gh0stless/SD2IEC-Tic-Tac-Edition/README.md

# SD2IEC-Tic-Tac-Edition

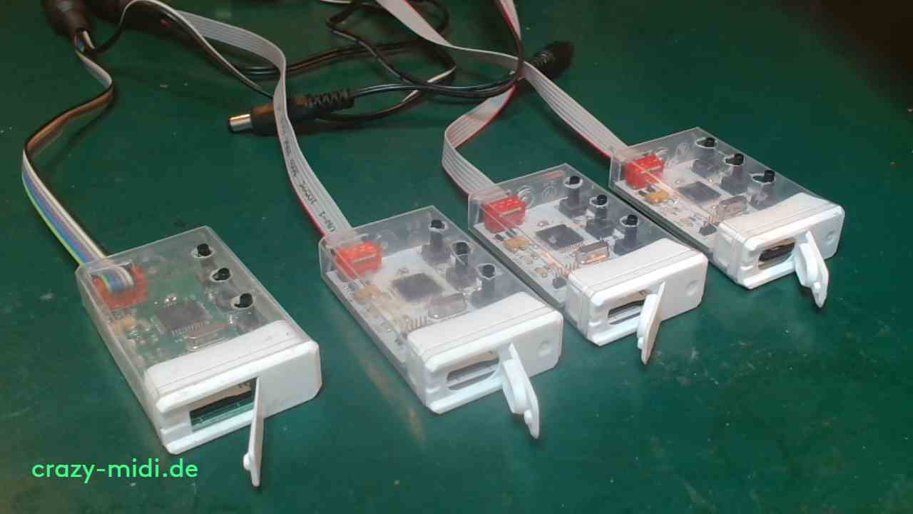
[picture p1: pics/SD2IEC_Tic_Tac.png]
SD2IEC_Tic_Tac


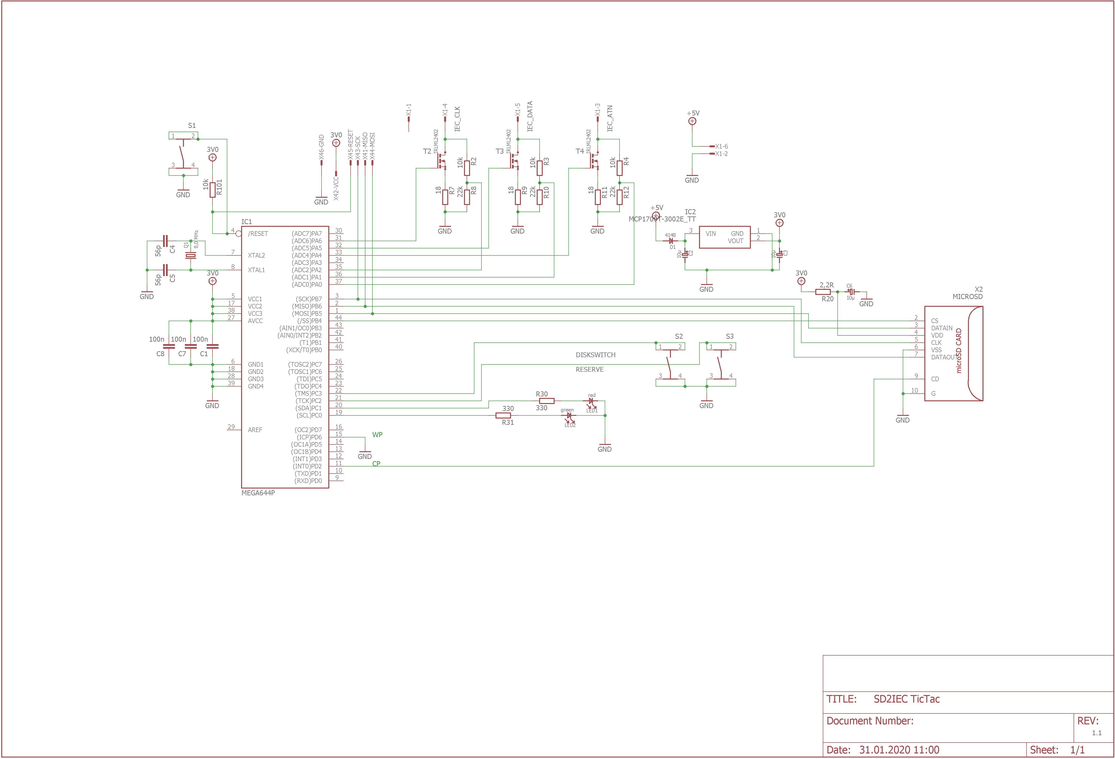
[picture p2: pics/schematic.png]
schematic


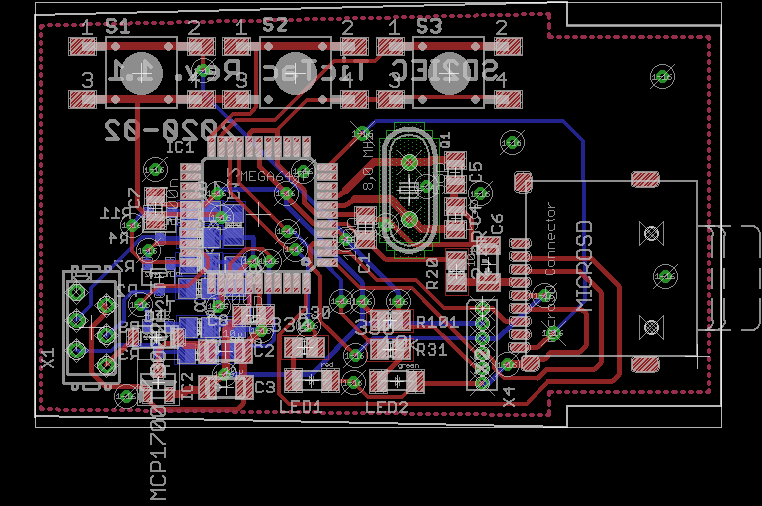
[picture p3: pics/board.png]
board


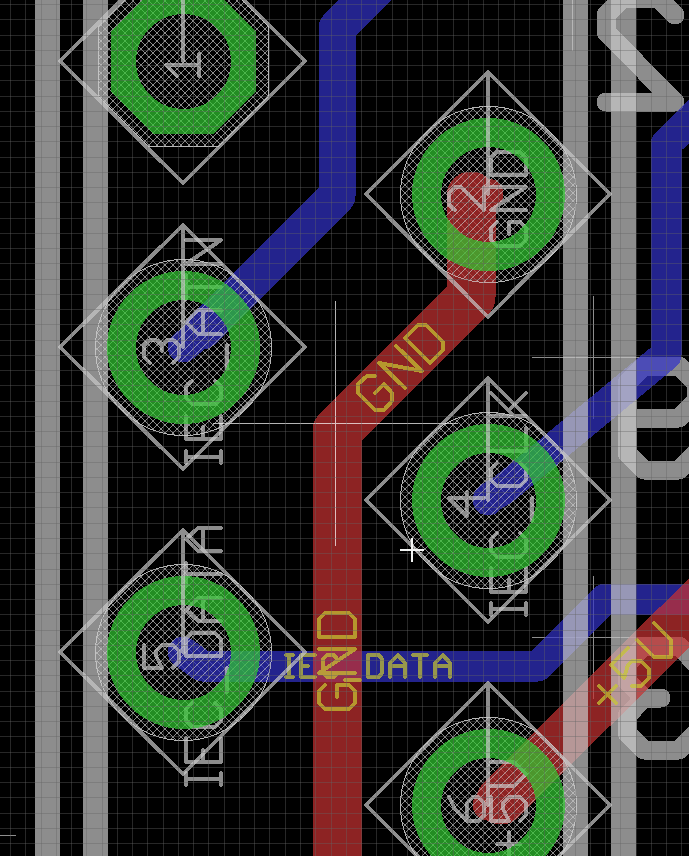
[picture p4: pics/connector.png]
connector


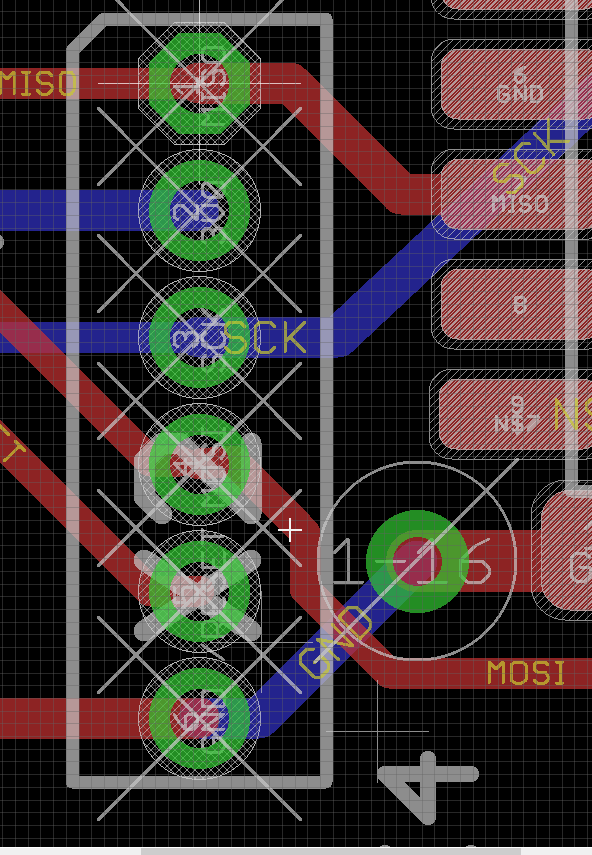
[picture p5: pics/ISP-connector.png]
ISP-connector
