gh0stless/SD2IEC-Tic-Tac-Edition/datasheets/microSD card connector/1.jpg

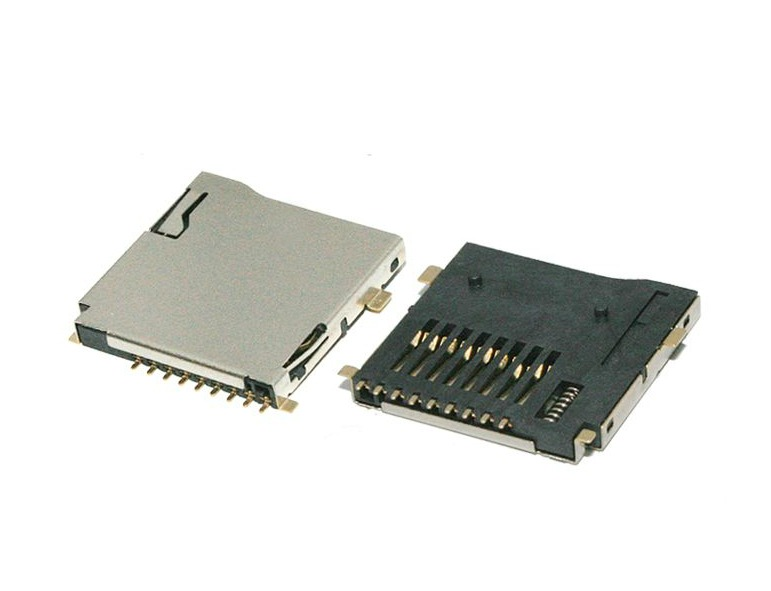
datasheets/microSD card connector/1.jpg
