gh0stless/SD2IEC-Tic-Tac-Edition/datasheets/microSD card connector/2.jpg

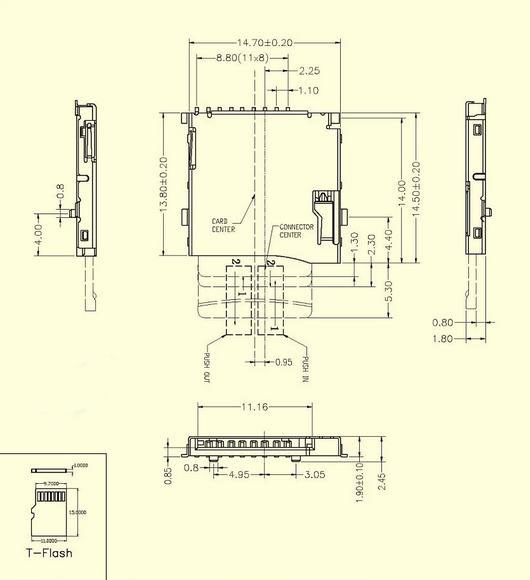
datasheets/microSD card connector/2.jpg
