gh0stless/SD2IEC-Tic-Tac-Edition/datasheets/microSD card connector/3.jpg

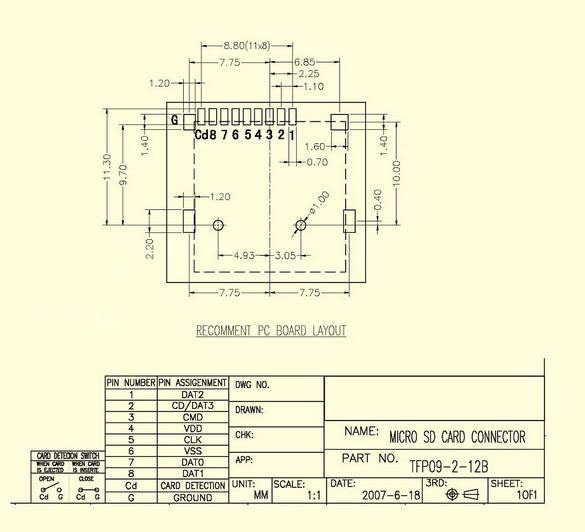
datasheets/microSD card connector/3.jpg
