gh0stless/SD2IEC-Tic-Tac-Edition/datasheets/microSD card connector/HTB1o9D0JFXXXXbVXXXXq6xXFXXX2.jpg

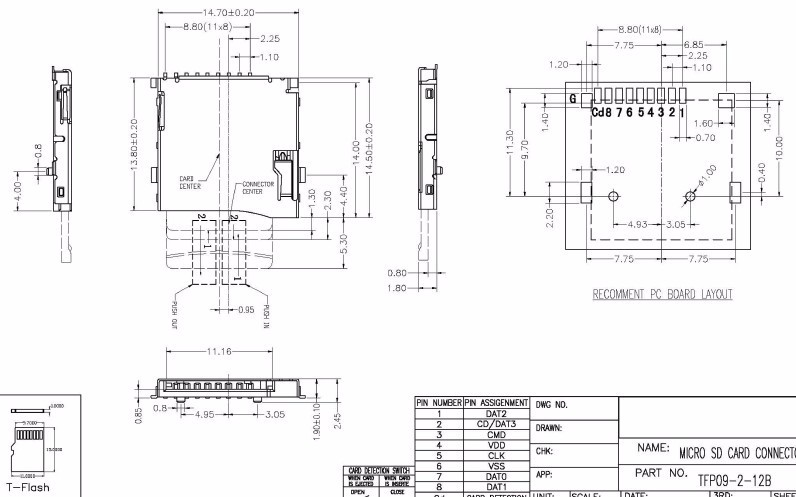
datasheets/microSD card connector/HTB1o9D0JFXXXXbVXXXXq6xXFXXX2.jpg
