gh0stless/SD2IEC-Tic-Tac-Edition/docs/SD2IEC Tic Tac - Bauteilliste (BOM).ods

Bauteilliste uSD2IEC Tic Tac Edition
Bauteil | Bezeichnung | Anzahl | Bauform | Bemerkung | Reichelt
 | PCB | 1
C1, C7, C8 | 100nF | 3 | 0805 |  | KEM X7R0805 100N (https://www.reichelt.de/vielschicht-kerko-100nf-50v-125-c-kem-x7r0805-100n-p207073.html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)
C4, C5 | 56pF | 2 | 0805 |  | KEM C0G0805 56P (https://www.reichelt.de/vielschicht-kerko-56pf-50v-125-c-kem-c0g0805-56p-p207032.html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)
C2, C3, C6 | 10µF | 3 | 0805 |  | T491A 10U 16 (https://www.reichelt.de/smd-tantal-10-f-16v-125-c-t491a-10u-16-p206441.html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)
D1 | 4148 | 1 | SOD-123 |  | 1N 4148W DIO (https://www.reichelt.de/kleinsignal-schalt-diode-100-v-150-ma-sod-123-1n-4148w-dio-p219382.html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)
IC1 | MEGA644P | 1 | TQFP44 |  | ATMEGA 644P20AU (https://www.reichelt.de/8-bit-atmega-avr-mikrocontroller-64-kb-20-mhz-tqfp-44-atmega-644p20au-p188777.html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)
IC2 | MCP1700T-3002E_TT | 1 | SOT95P237X112-3N | HC 6206 | MCP 1700T-3002E (https://www.reichelt.de/ldo-regler-fest-3-v-sot-23-3-mcp-1700t-3002e-p216941.html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)
LED1 | LED1206 red | 1 | 1206 |  | SMD-LED 1206 RT (https://www.reichelt.de/led-smd-3216-1206-rot-12-mcd-120--smd-led-1206-rt-p31439.html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)
LED2 | LED1206 green | 1 | 1206 |  | SMD-LED 1206 GN (https://www.reichelt.de/smd-led-1206-superhell-gruen-gap-12-mcd-120-3-2-x-1-6-mm--smd-led-1206-gn-p31440.html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)
Q1 | 8MHz | 1 | HC49/S |  | 8,0000-HC49U-S (https://www.reichelt.de/standardquarz-grundton-8-000000-mhz-8-0000-hc49u-s-p32845.html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)
R2, R3, R4, R101 | 10k | 4 | 0805 |  | WAL WR08X1002FTL (https://www.reichelt.de/smd-widerstand-0805-10-kohm-125-mw-1--wal-wr08x1002ftl-p346579.html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)
R7, R9, R11 | 18 | 3 | 0805 |  | WAL WR08X18R0FTL (https://www.reichelt.de/smd-widerstand-0805-18-ohm-125-mw-1--wal-wr08x18r0ftl-p346592.html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)
R8, R10, R12 | 22k | 3 | 0805 |  | WAL WR08X2202FTL (https://www.reichelt.de/smd-widerstand-0805-22-kohm-125-mw-1--wal-wr08x2202ftl-p346600.html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)
R20 | 2,2 | 1 | 0805 |  | RND 1550805 AA (https://www.reichelt.de/smd-widerstand-0805-2-2-ohm-125-mw-5--rnd-1550805-aa-p250218.html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)
R30, R31 | 330 | 2 | 0805 |  | RND 1550805 BT (https://www.reichelt.de/smd-widerstand-0805-330-ohm-125-mw-5--rnd-1550805-bt-p250263.html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)
T2,T3,T4 | IRLML2402 | 3 | SOT23 |  | IRLML 2402 (https://www.reichelt.de/mosfet-n-kanal-20-v-1-2-a-rds-on-0-25-ohm-sot-23-irlml-2402-p108736.html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)
S1, S2, S3 | TASTER-9314_SMD | 3
X1 | MICROMATCH-6 | 1 |  | Micromatch Buchse | MPE 369-1-006 (https://www.reichelt.de/buchsenleisten-micromatch-1-27-mm-2x03-gerade-mpe-369-1-006-p120008.html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)
X1-2 | MICROMATCH-6 | 1 |  | Micromatch Stecker | MPE 372-1-006 (https://www.reichelt.de/idc-stiftwanne-micro-match-06-polig-mpe-372-1-006-p120050.html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)
X2 | MICROSD | 1 |  | µSD card slot
X4 | 1X6 | 1 |  | Stiftleisten 1,27 mm 1X50 | SL 1X10G 1,27 (https://www.reichelt.de/10pol-stiftleiste-gerade-rm-1-27-sl-1x10g-1-27-p51692.html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)
 |  | 1 |  | DC-Kabel
 |  | 1 |  | Flachbandkabel-6x
 |  | 1 |  | Hohlstecker,5,5-2,1 | HS 21-9 (https://www.reichelt.de/hohlstecker-knickschutz-aussen-5-5-mm-innen-2-1-mm-hs-21-9-p8647.html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)
 |  | 1 |  | DIN-Stecker, 6-Pol., Hufeisenform | MAS 60 (https://www.reichelt.de/din-stecker-6-polig-mas-60-p11200.html?GROUP=C1651&START=0&SORT=-rank&OFFSET=16&nbc=1)
 |  | 1 |  | DC-DC-Adapter,5,5-2,1 | DC-AD 072241 (https://www.reichelt.de/kupplung-kupplung-aussen-5-5-mm-innen-2-1-mm-dc-ad-072241-p202907.html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)
 |  | 1 |  | µSD Karte 2GB | TS2GUSD (https://www.reichelt.de/microsd-speicherkarte-2gb-transcend-mit-adapter-ts2gusd-p171415.html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)
 |  | 1 |  | Tic Tac Box
