gh0stless/SD2IEC-Tic-Tac-Edition/pcb/SD2IEC TicTac.brd

## EAGLE design pcb/SD2IEC TicTac.brd (2023-07-09)

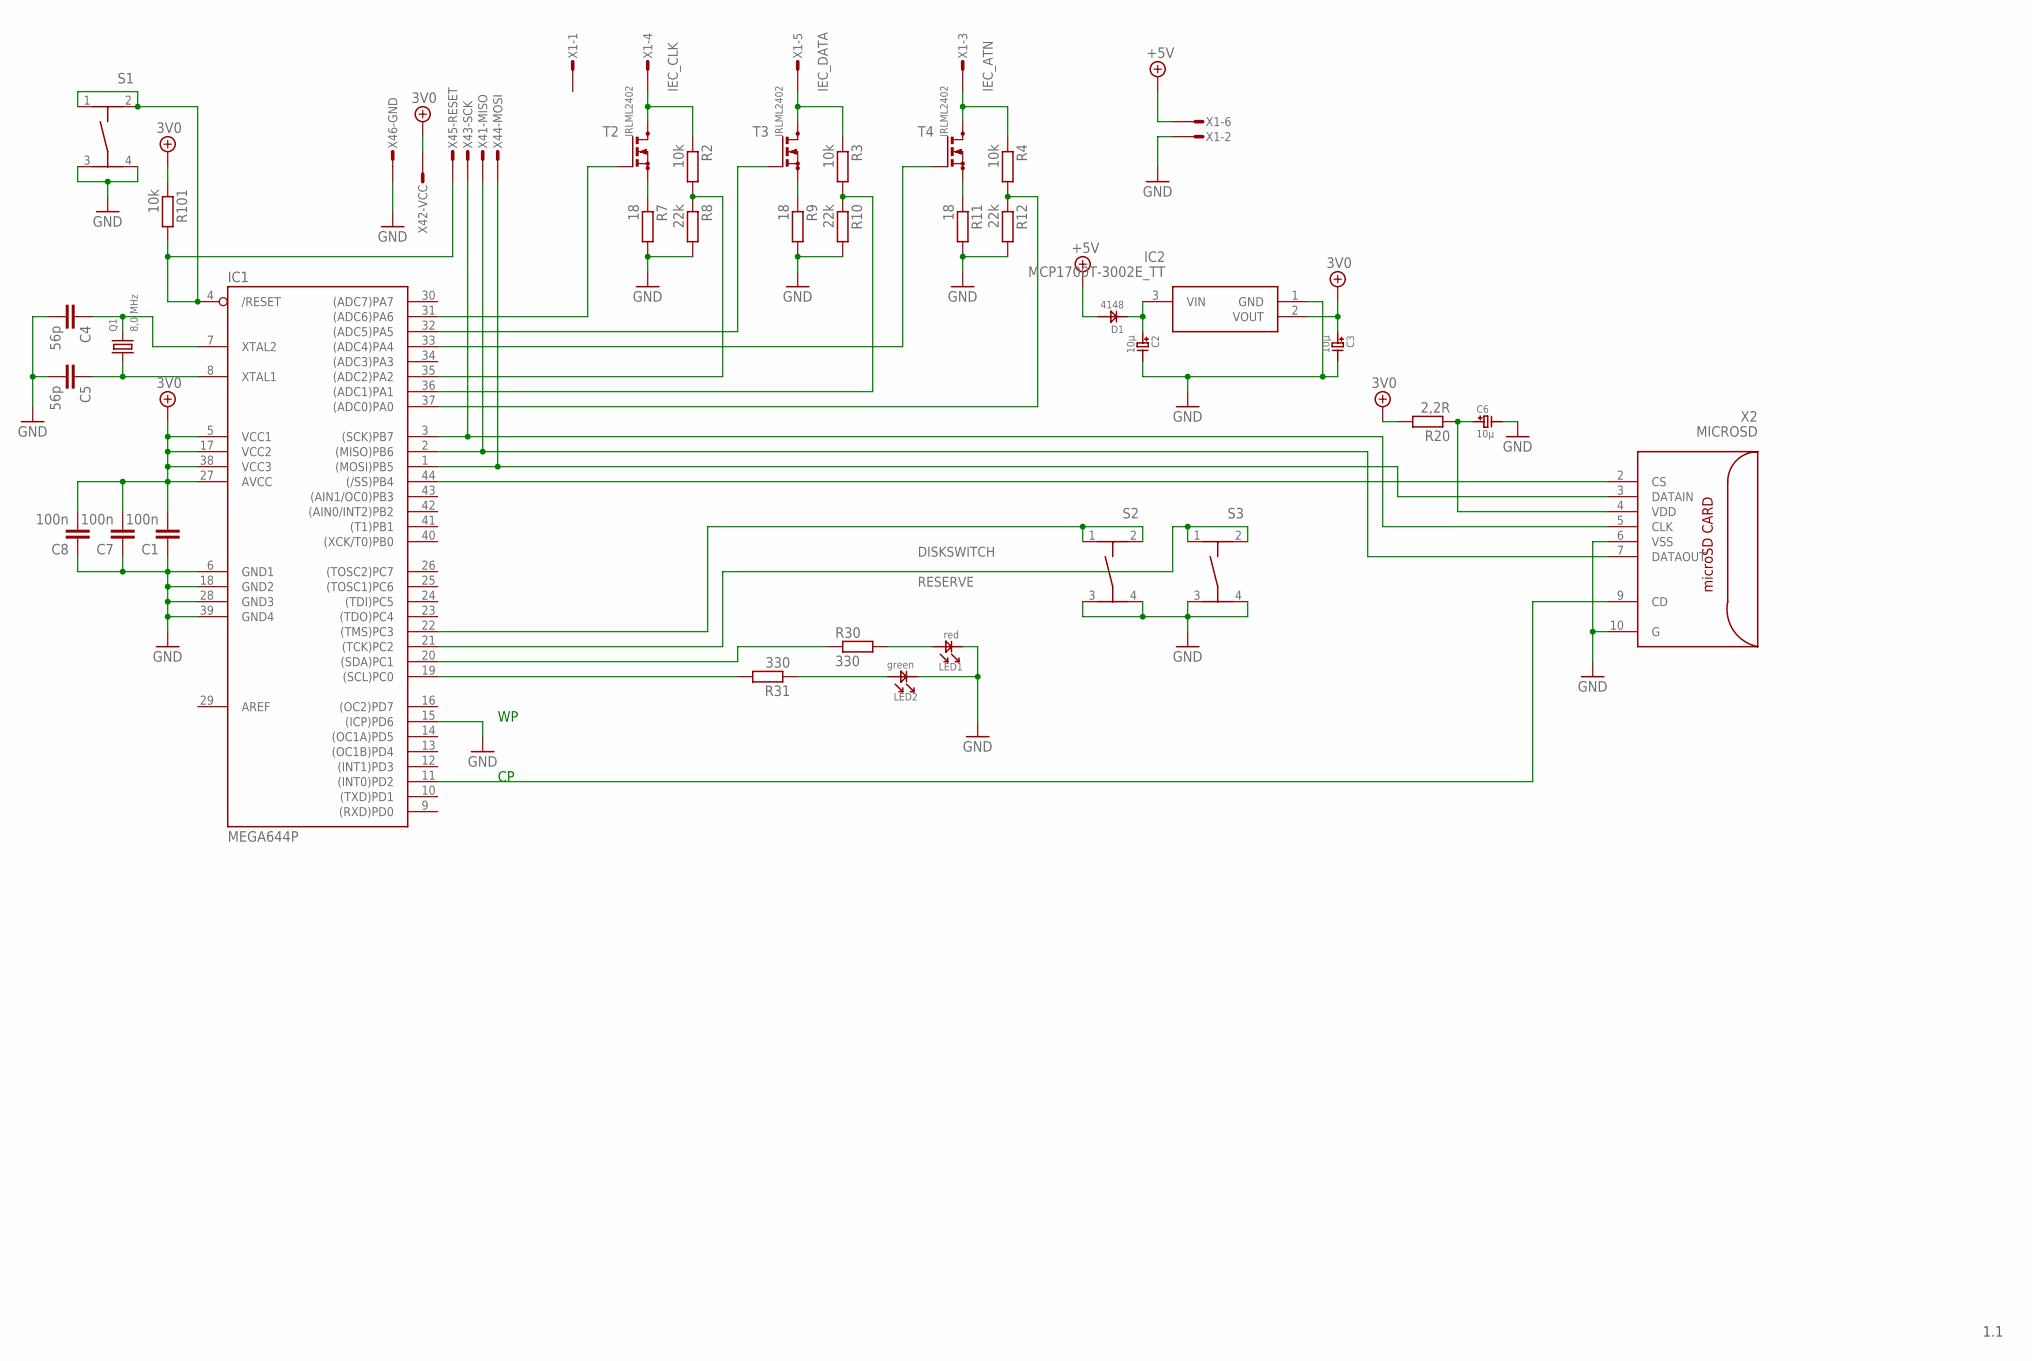
[picture p10: schematic SD2IEC TicTac.sch]

Parts:
C1, C7, C8: 100n; C0805K
C2, C3, C6: 10µ; C_TANTAL_A
C4, C5: 56p; C0805K
D1: 4148; SOD-123
IC1: MEGA644P; TQFP44
IC2: MCP1700T-3002E_TT; SOT95P237X112-3N
LED1: red; LED1206
LED2: green; LED1206
Q1: 8,0 MHz; HC49/S
R2, R3, R4, R101: 10k; R0805
R7, R9, R11: 18; R0805
R8, R10, R12: 22k; R0805
R20: 2,2R; R0805
R30, R31: 330; R0805
S1, S2, S3: TASTER-9314_SMD
T2, T3, T4: IRLML2402; SOT23_C
X1: MICROMATCH-6_PIN; MICROMATCH-6
X2: MICROSD; MICRO_SD_CONNECTOR
X4: AVR-ISP_1X6; 1X6_ISP

Connections:
3V0: C1.2, C3.1, C7.2, C8.2, IC1.5 (VCC1), IC1.17 (VCC2), IC1.27 (AVCC), IC1.38 (VCC3), IC2.2 (VOUT), R20.2, R101.1, X4.2
+5V: D1.2, X1.6
/RESET: IC1.4 (/RESET), R101.2, S1.1, S1.2, X4.5
ATN: IC1.37 ((ADC0)PA0), R4.2, R12.1
CLK: IC1.35 ((ADC2)PA2), R2.2, R8.1
DATA: IC1.36 ((ADC1)PA1), R3.2, R10.1
DISKSWITCH: IC1.22 ((TMS)PC3), S2.1, S2.2
GND: C1.1, C2.2, C3.2, C4.2, C5.2, C6.2, C7.1, C8.1, IC1.6 (GND1), IC1.15 ((ICP)PD6), IC1.18 (GND2), IC1.28 (GND3), IC1.39 (GND4), IC2.1 (GND), LED1.1, LED2.1, R7.2, R8.2, R9.2, R10.2, R11.2, R12.2, S1.3, S1.4, S2.3, S2.4, S3.3, S3.4, X1.2, X2.6 (VSS), X2.10 (G), X4.6
IEC_ATN: R4.1, T4.3 (D), X1.3
IEC_CLK: R2.1, T2.3 (D), X1.4
IEC_DATA: R3.1, T3.3 (D), X1.5
LED2: LED2.2, R31.1
MISO: IC1.2 ((MISO)PB6), X2.7 (DATAOUT), X4.1
MOSI: IC1.1 ((MOSI)PB5), X2.3 (DATAIN), X4.4
unnamed: LED1.2, R30.2
unnamed: C2.1, D1.1, IC2.3 (VIN)
unnamed: C5.1, IC1.8 (XTAL1), Q1.1
unnamed: C4.1, IC1.7 (XTAL2), Q1.2
unnamed: C6.1, R20.1, X2.4 (VDD)
unnamed: IC1.11 ((INT0)PD2), X2.9 (CD)
unnamed: IC1.32 ((ADC5)PA5), T3.1 (G)
unnamed: IC1.33 ((ADC4)PA4), T4.1 (G)
unnamed: IC1.31 ((ADC6)PA6), T2.1 (G)
unnamed: R7.1, T2.2 (S)
unnamed: R9.1, T3.2 (S)
unnamed: R11.1, T4.2 (S)
PC0: IC1.19 ((SCL)PC0), R31.2
PC1: IC1.20 ((SDA)PC1), R30.1
RESERVE: IC1.21 ((TCK)PC2), S3.1, S3.2
SCK: IC1.3 ((SCK)PB7), X2.5 (CLK), X4.3
SS: IC1.44 ((/SS)PB4), X2.2 (CS)

Notes on the sheet:
1.1

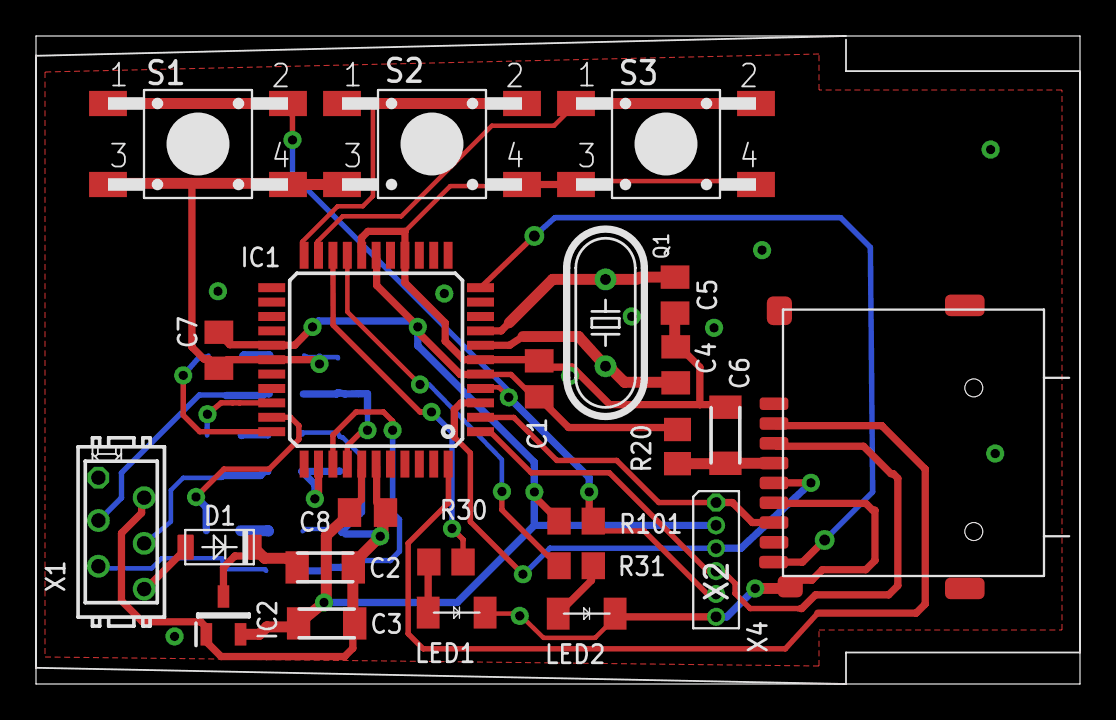
[picture p11: board SD2IEC TicTac.brd from above]

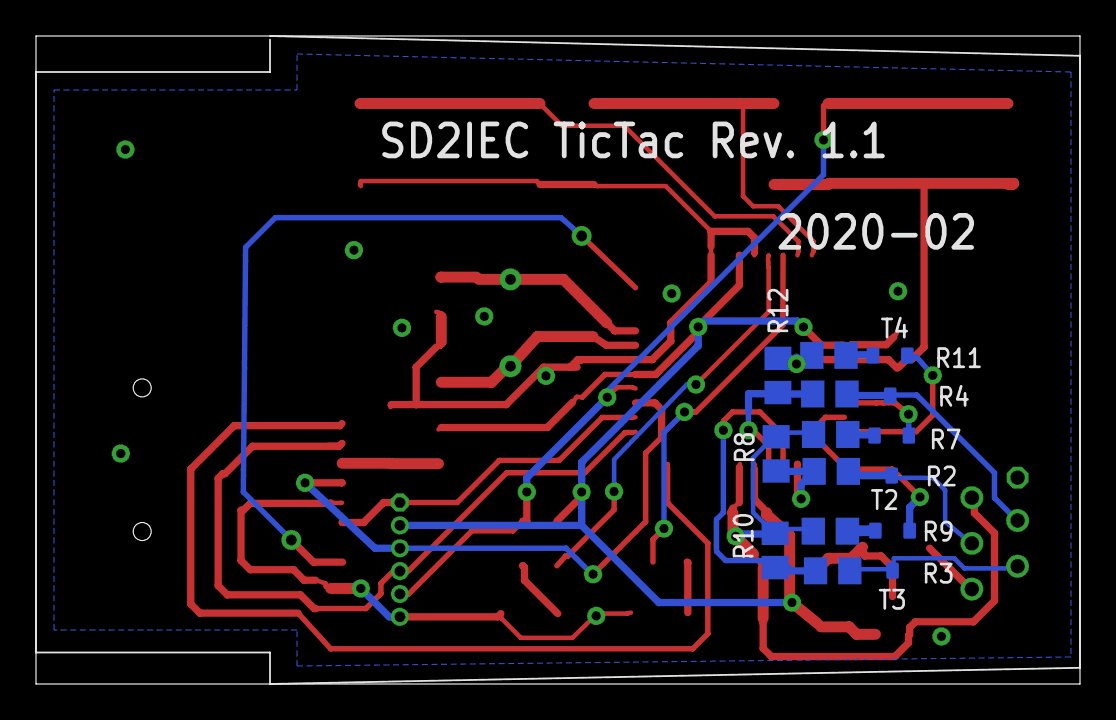
[picture p12: board SD2IEC TicTac.brd from below]

Board: 2 copper layers, 58.0 x 36.0 mm, 36 parts (12 on the bottom side), 31 nets.
