gh0stless/SD2IEC-Tic-Tac-Edition/(commit log)

2023-08-02 edit BOM
    [uSD2IEC Tic Tac Bauteilliste (BOM).ods, uSD2IEC Tic Tac Bauteilliste.ods]
2023-08-03 add gerbers
    [SD2IEC TicTac.GBL, SD2IEC TicTac.GBO, SD2IEC TicTac.GBP, SD2IEC TicTac.GBS, SD2IEC TicTac.GTL, SD2IEC TicTac.GTO, SD2IEC TicTac.GTP, SD2IEC TicTac.GTS]
